wagiminator/ATtiny412-I2C-Rotary-Encoder/hardware/I2C_RotaryEncoder_schematic.pdf

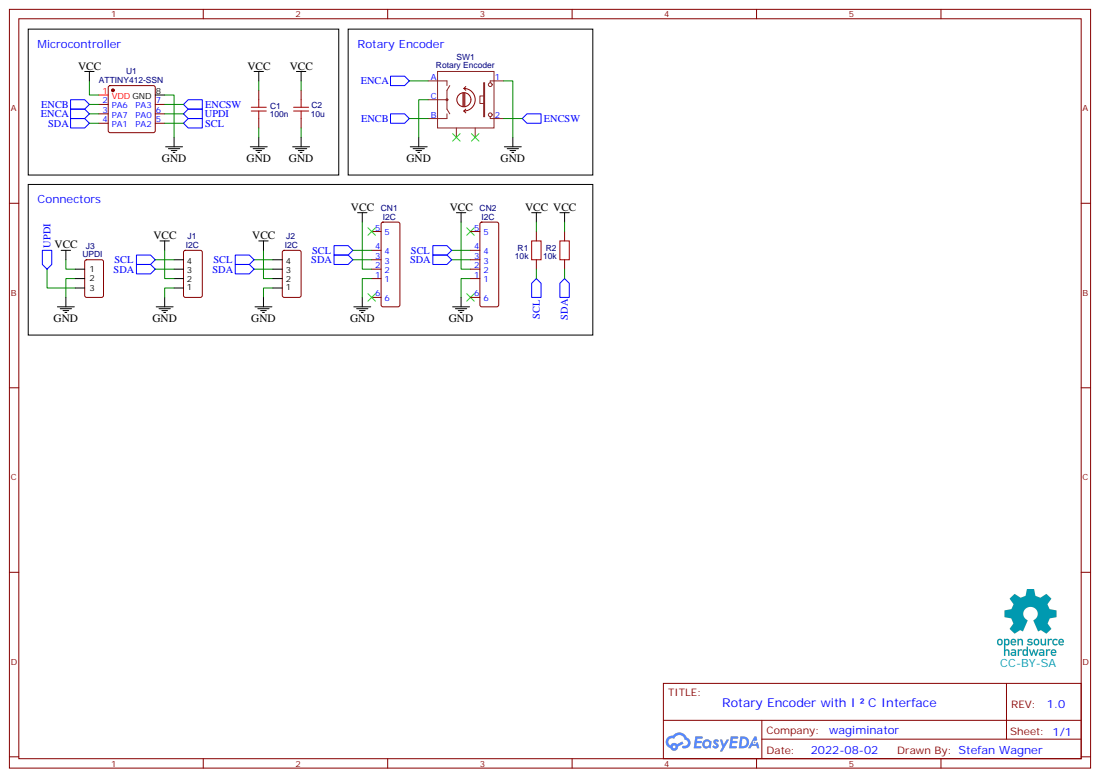
[picture p5: page 1]

Drawn By: Stefan Wagner
