wagiminator/ATtiny412-I2C-Rotary-Encoder/(threads)

Thread 1 (2022-08-19):

Qwiic is trademarked

FreezeS, 2022-08-19:
Hi,

Just to let you know that the brand "Qwiic" is trademarked so you might receive a trademark infringement notification: https://uspto.report/TM/88099558
Sparkfun might be legally forced to send the Cease and Desist otherwise they might lose their trademark.

We called our connectors "I2C 3V3" to avoid this.

wagiminator, 2022-08-19:
Hi,
thank you for the hint. I've replaced it with "I2C".

Closed 2022-08-19.

Thread 2 (2023-11-05):

rpi python - only get state of rotary encoder wheel but not from switch

pwallner, 2023-11-05:
Hi,

I tried to get the value with python on raspberry pi via smbus, but I don't know how to get the **rotary enoder switch** state, could you please help?
Here my code for now which is reading the value of the wheel:
```python
from smbus import SMBus
import time

addr = 0x36 # bus address
bus = SMBus(1) # indicates /dev/ic2-1
oldvalue = 0

while True:
	try:
		z = bus.read_byte(addr)
		if z != oldvalue:
			oldvalue = z
			print(z, end = "\r")

		time.sleep(0.25)
	except:
		print('exiting...')
		break
```
And second question, is there a better way to get the actual value without a while loop?

Thank you in advance,
Patrick

wagiminator, 2023-11-05:
Hi, I'm not familiar with smbus. However, you have to read at least 3 bytes from the I2C bus. The first 2 bytes are the rotary value, the third byte ist the switch state.

wagiminator, 2023-11-18:
I can't understand your changes at the moment. Have you also changed anything in the interrupt service routines? (sei(), cli() and ISR belong to interrupts, which are triggered whenever the rotary encoder is messed with or I2C communication is running). It's also not entirely clear to me when you're talking about the source code for the ATtiny (it's written in C) and when you're talking about the software on the other side of the I2C connection (in your case, it's probably Python on the Raspberry Pi).
